alicepergatta/KisosvetV2/Photos/prototype/Prototype wih bradboard.jpg

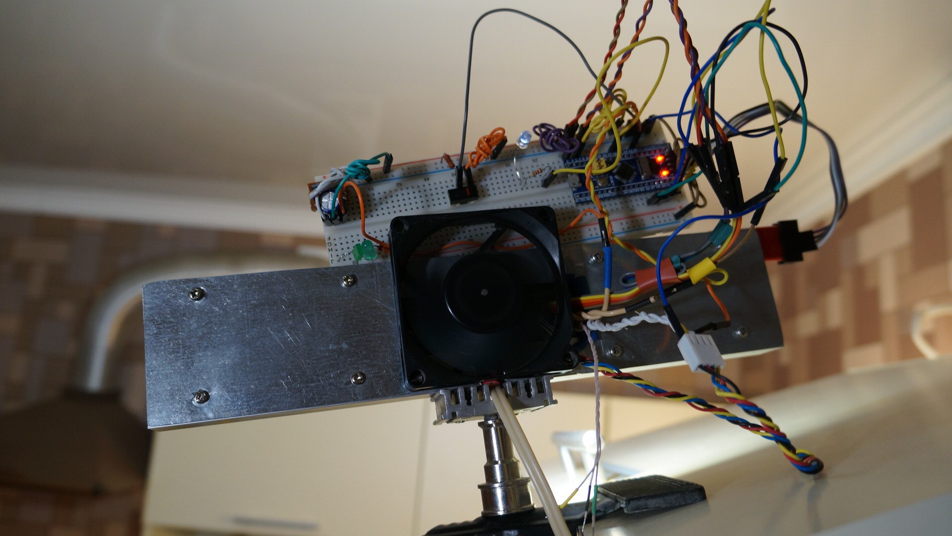
Photos/prototype/Prototype wih bradboard.jpg
