alicepergatta/KisosvetV2/Photos/prototype/screw mount.jpg

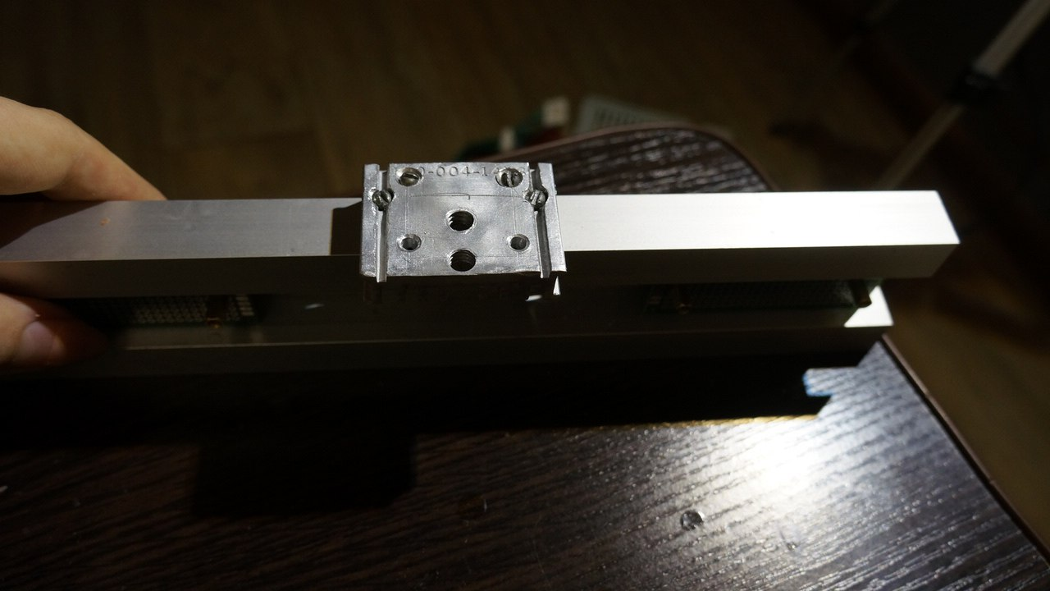
Photos/prototype/screw mount.jpg
