alicepergatta/KisosvetV2/Photos/prototype/Aluminium Knobs.jpg

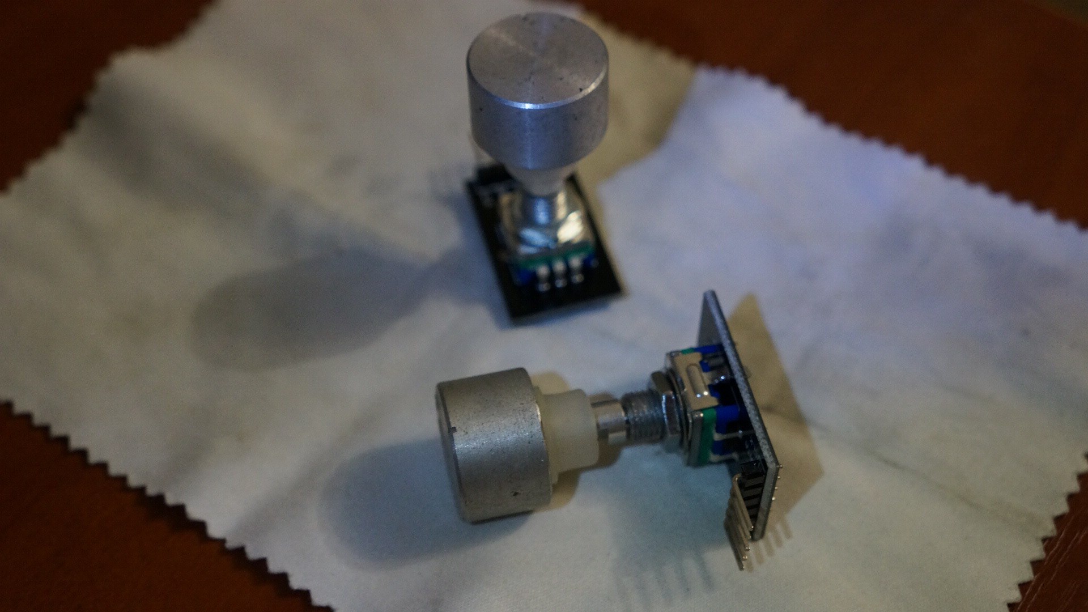
Photos/prototype/Aluminium Knobs.jpg
