alicepergatta/KisosvetV2/Photos/prototype/front side.jpg

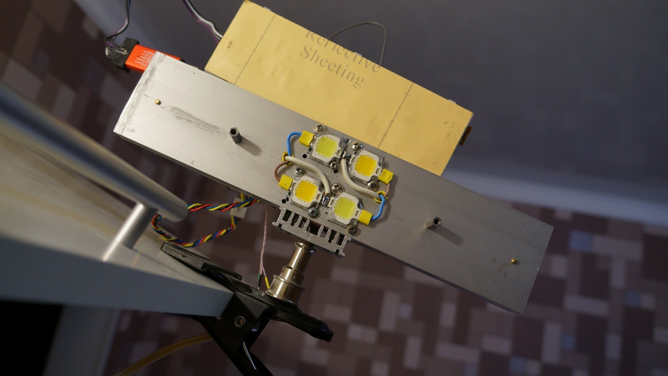
Photos/prototype/front side.jpg
