alicepergatta/KisosvetV2/Photos/prototype/prototype rear side.jpg

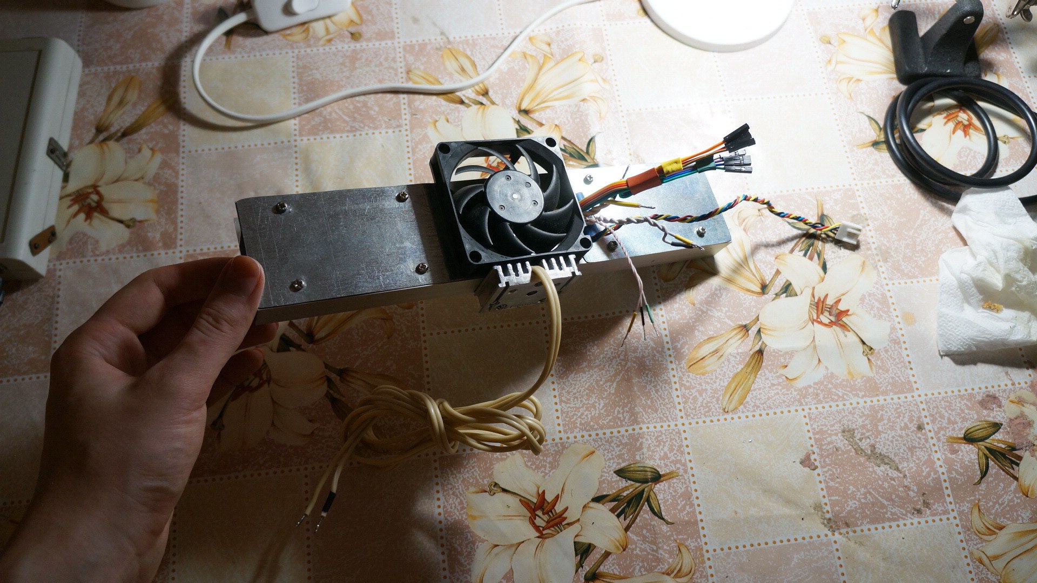
Photos/prototype/prototype rear side.jpg
