alicepergatta/KisosvetV2/png-schematic/block-scheme.png

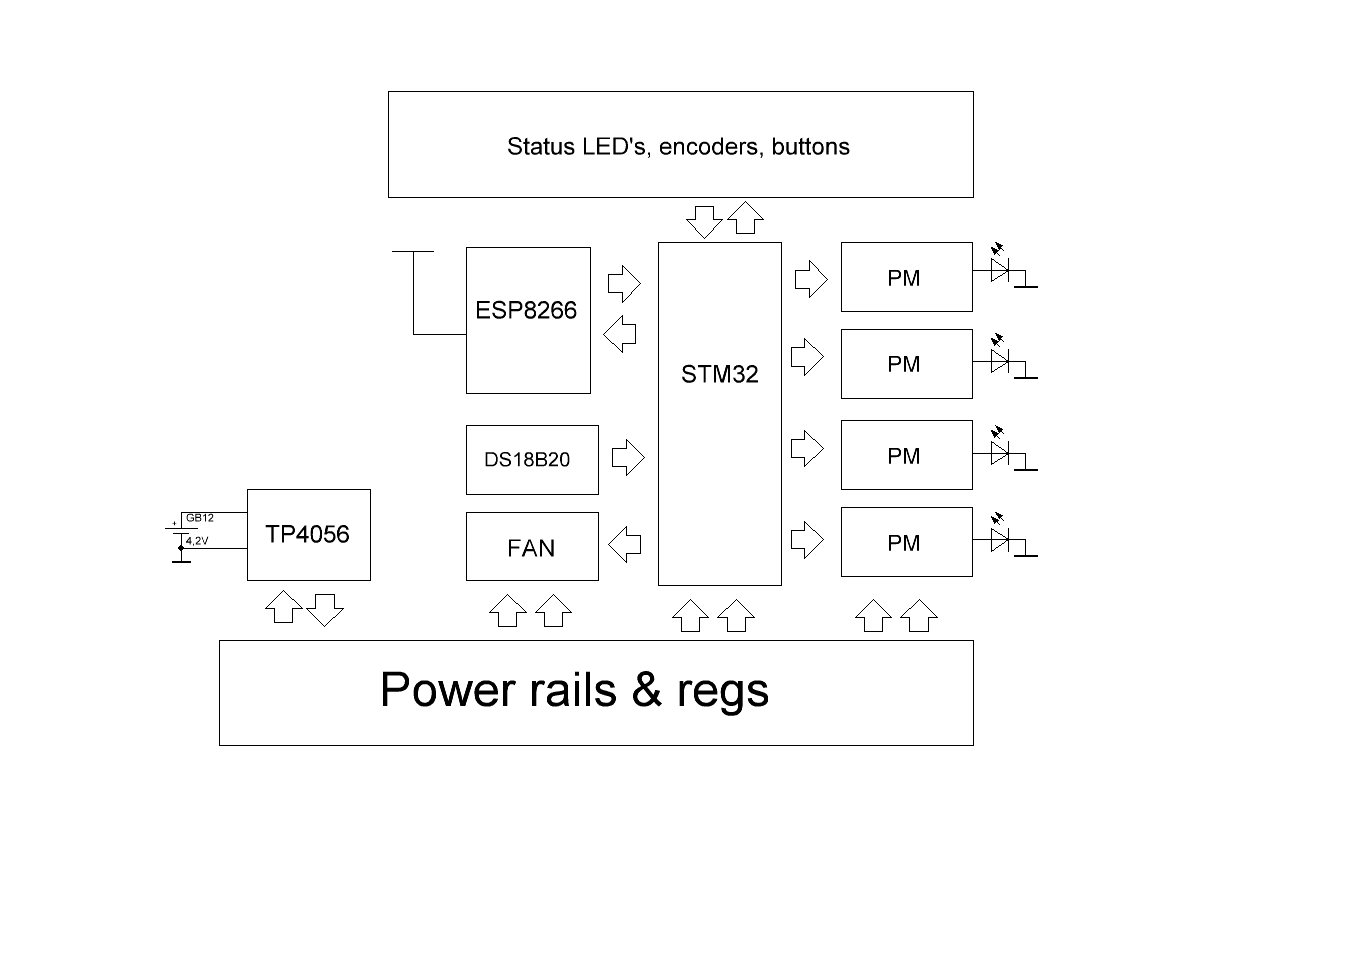
png-schematic/block-scheme.png
