alicepergatta/KisosvetV2/png-schematic/control.png

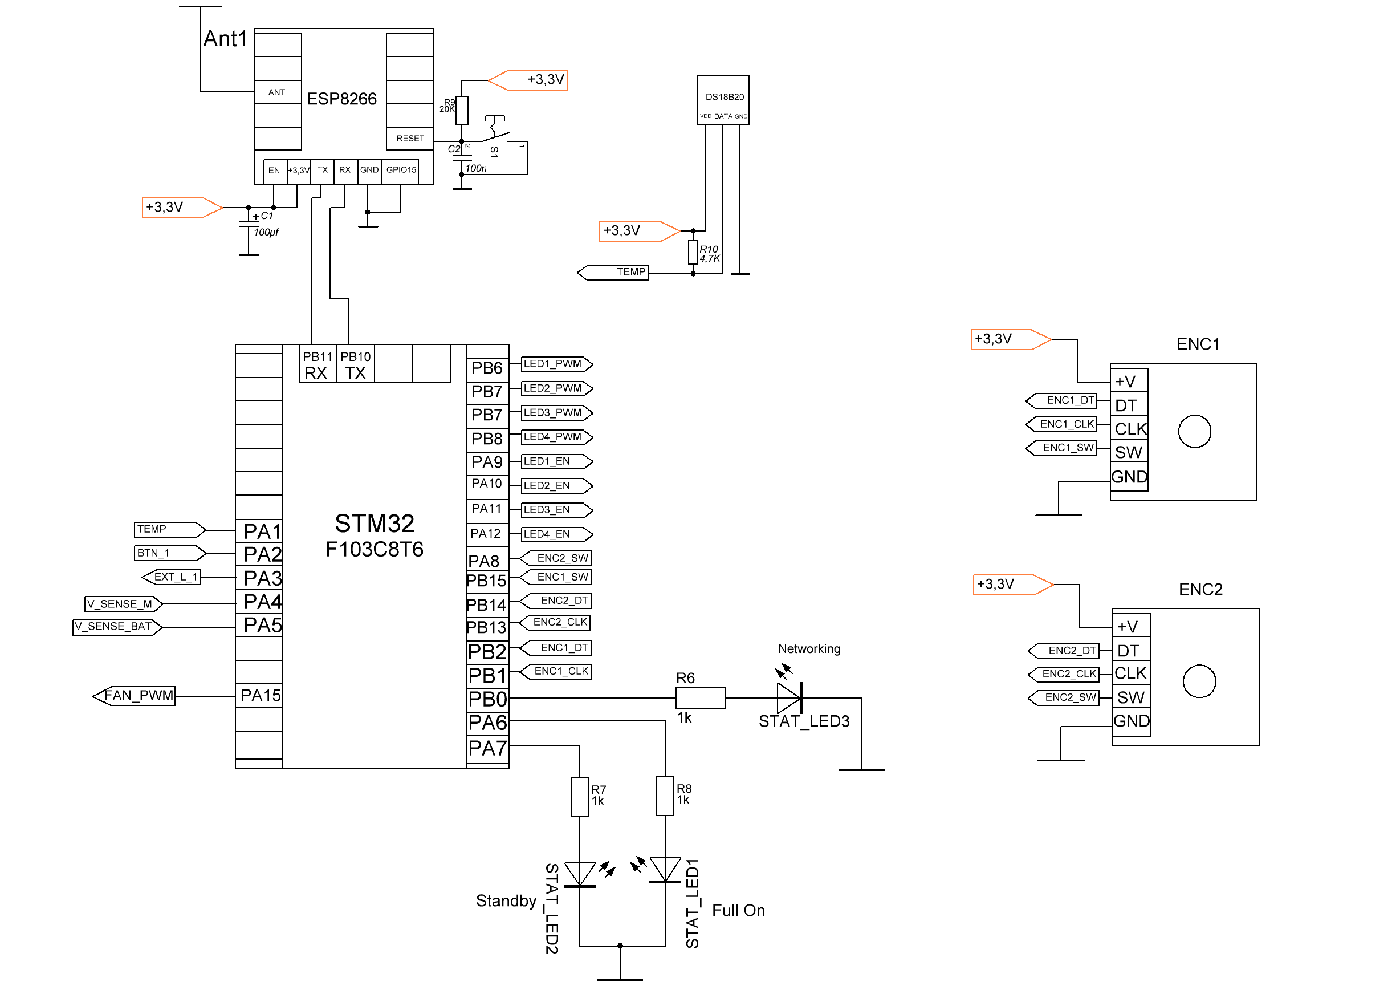
png-schematic/control.png
