alicepergatta/KisosvetV2/png-schematic/Power Module.png

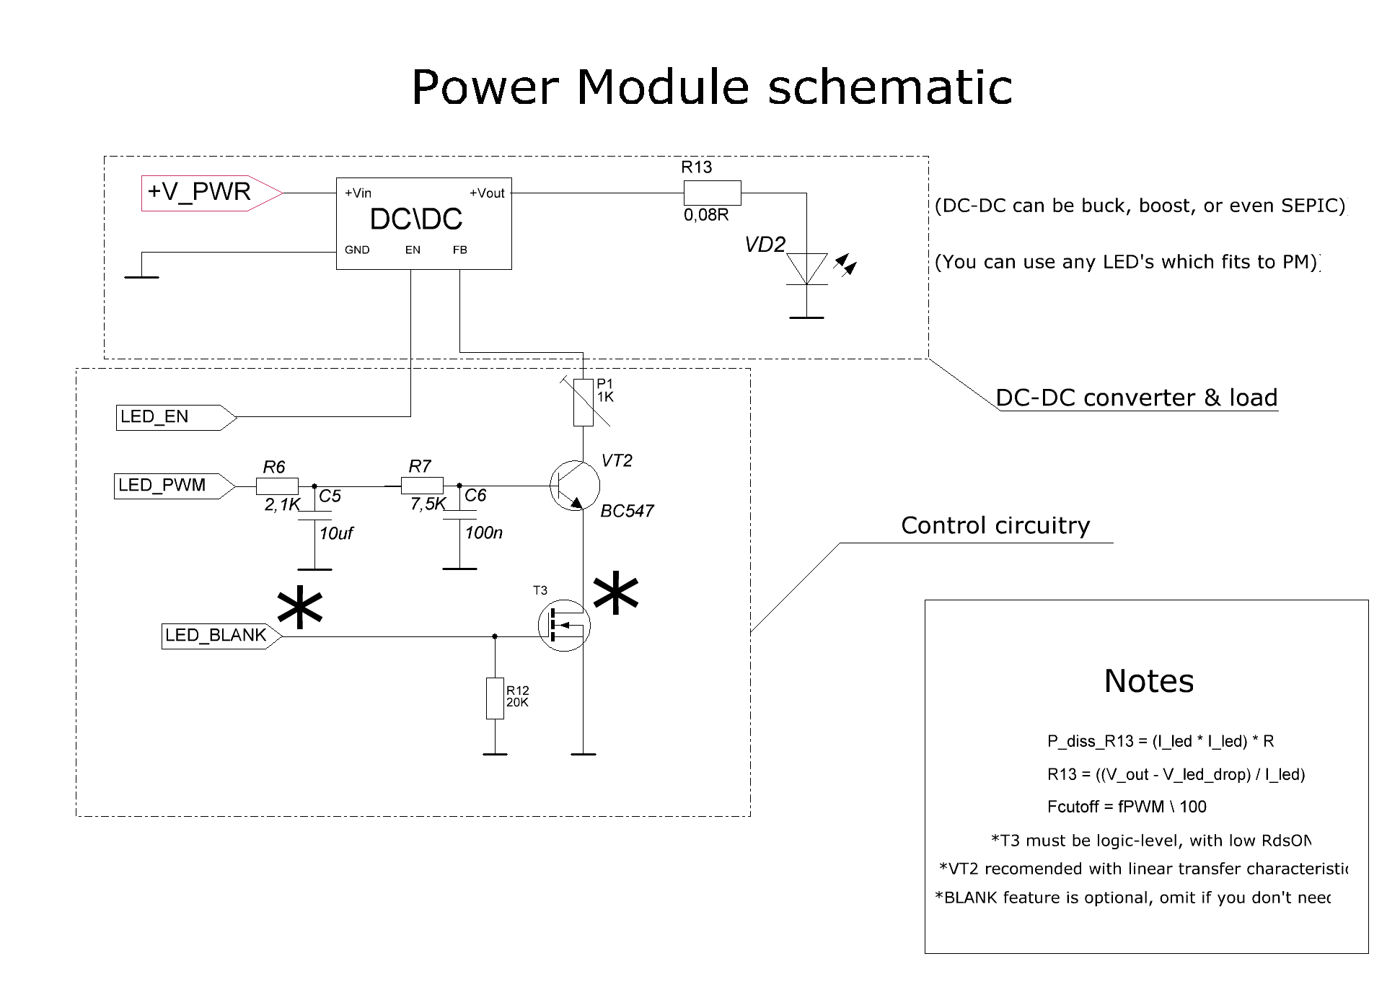
png-schematic/Power Module.png
