alicepergatta/KisosvetV2/(list of files, drawings)

Other design files:
PCB/4pcs_10W_PM.lay6
schematic/KisoSvet_V2.spl7
