alicepergatta/KisosvetV2/stm32/Src/main.c

/**
  ******************************************************************************
  * File Name          : main.c
  * Description        : Main program body
  ******************************************************************************
  *
  * COPYRIGHT(c) 2016 STMicroelectronics
  *
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
  ******************************************************************************
  */
/* Includes ------------------------------------------------------------------*/
#include "main.h"
#include "stm32f1xx_hal.h"
#include "CLI.h"
#include "stdio.h"
#include "stm32f1xx.h"

ADC_HandleTypeDef hadc1;

RTC_HandleTypeDef hrtc;

TIM_HandleTypeDef htim2;
TIM_HandleTypeDef htim3;
TIM_HandleTypeDef htim4;

UART_HandleTypeDef huart3;
//EXTI_InitTypeDef EXTI_InitStruct;

/* USER CODE BEGIN PV */





	//configuration
short L_ECHO = 0;  //Local echo(CLI), to see what you type 1 - ON, 0 - OFF
short CMD_ANSWER = 1; //Write reply on command or not, not yet implemented

/* USER CODE END PV */

void Auxiliary(void);
void SystemClock_Config(void);
void Error_Handler(void);
void EXTI_Configuration(void);
static void MX_GPIO_Init(void);
static void MX_TIM4_Init(void);
static void MX_ADC1_Init(void);
static void MX_RTC_Init(void);
static void MX_TIM2_Init(void);
static void MX_TIM3_Init(void);
static void MX_USART3_UART_Init(void);
//void EXTI_Init(EXTI_InitTypeDef* EXTI_InitStruct); 
void HAL_TIM_MspPostInit(TIM_HandleTypeDef *htim);
void HAL_ADCEx_InjectedConvCpltCallback(ADC_HandleTypeDef* hadc);
int LED_CVAL(int, int);
void LED_SW(void);
void CReturnCmd(void);
void GetTemperature(void);
void FlashTest(void); //debug
void ButtonFunctions(short btn_num, short btn_state); //Buttons functionality


/* USER CODE BEGIN PFP */

/* USER CODE END PFP */

int main(void)
{

  /* MCU Configuration----------------------------------------------------------*/

  /* Reset of all peripherals, Initializes the Flash interface and the Systick. */
  HAL_Init();
		
  //* Configure the system clock */
  SystemClock_Config();

  /* Initialize all configured peripherals */
  MX_GPIO_Init();
  MX_TIM4_Init();
  MX_ADC1_Init();
  MX_RTC_Init();
  MX_TIM2_Init();
	MX_TIM3_Init();
	
  MX_USART3_UART_Init();
	__HAL_UART_ENABLE_IT(&huart3, UART_IT_RXNE);
	
	//TIM4 start(LED's PWM)
HAL_TIM_PWM_Start(&htim4, TIM_CHANNEL_1);
HAL_TIM_PWM_Start(&htim4, TIM_CHANNEL_2);
HAL_TIM_PWM_Start(&htim4, TIM_CHANNEL_3);
HAL_TIM_PWM_Start(&htim4, TIM_CHANNEL_4);

	//TIM2 start (FAN PWM)
HAL_TIM_PWM_Start(&htim2, TIM_CHANNEL_1);
	//TIM3 start
HAL_TIM_Base_Start(&htim3);


//GPIOExtiConfig(2, ButtonFunctions, (void*)1, BTN_1_Pin);


HAL_ADCEx_InjectedStart_IT(&hadc1); //start ADC
void GPIO_EXTILineConfig(uint8_t GPIO_PortSourceB, uint8_t GPIO_PinSource15); //EXTI for ENC1_SW
void GPIO_EXTILineConfig(uint8_t GPIO_PortSourceA, uint8_t GPIO_PinSource8); //EXTI for ENC2_SW

	//Sending greeting in terminal once after reset
printf("Meow! Kisosvet V2 has started \n\r");


  /* Infinite loop */
  /* USER CODE BEGIN WHILE */
  while (1)
  {

 
LED_SW();	//call LED on\off function
CReturnCmd(); //CLI functions
Auxiliary(); //Periferials function

  /* USER CODE BEGIN 3 */

  }
  /* USER CODE END 3 */

}

/** System Clock Configuration
*/
void SystemClock_Config(void)
{

  RCC_OscInitTypeDef RCC_OscInitStruct;
  RCC_ClkInitTypeDef RCC_ClkInitStruct;
  RCC_PeriphCLKInitTypeDef PeriphClkInit;

    /**Initializes the CPU, AHB and APB busses clocks 
    */
  RCC_OscInitStruct.OscillatorType = RCC_OSCILLATORTYPE_LSI|RCC_OSCILLATORTYPE_HSE;
  RCC_OscInitStruct.HSEState = RCC_HSE_ON;
  RCC_OscInitStruct.HSEPredivValue = RCC_HSE_PREDIV_DIV1;
  RCC_OscInitStruct.HSIState = RCC_HSI_ON;
  RCC_OscInitStruct.LSIState = RCC_LSI_ON;
  RCC_OscInitStruct.PLL.PLLState = RCC_PLL_ON;
  RCC_OscInitStruct.PLL.PLLSource = RCC_PLLSOURCE_HSE;
  RCC_OscInitStruct.PLL.PLLMUL = RCC_PLL_MUL6;
  if (HAL_RCC_OscConfig(&RCC_OscInitStruct) != HAL_OK)
  {
    Error_Handler();
  }

    /**Initializes the CPU, AHB and APB busses clocks 
    */
  RCC_ClkInitStruct.ClockType = RCC_CLOCKTYPE_HCLK|RCC_CLOCKTYPE_SYSCLK
                              |RCC_CLOCKTYPE_PCLK1|RCC_CLOCKTYPE_PCLK2;
  RCC_ClkInitStruct.SYSCLKSource = RCC_SYSCLKSOURCE_PLLCLK;
  RCC_ClkInitStruct.AHBCLKDivider = RCC_SYSCLK_DIV1;
  RCC_ClkInitStruct.APB1CLKDivider = RCC_HCLK_DIV2;
  RCC_ClkInitStruct.APB2CLKDivider = RCC_HCLK_DIV4;

  if (HAL_RCC_ClockConfig(&RCC_ClkInitStruct, FLASH_LATENCY_1) != HAL_OK)
  {
    Error_Handler();
  }

  PeriphClkInit.PeriphClockSelection = RCC_PERIPHCLK_RTC|RCC_PERIPHCLK_ADC;
  PeriphClkInit.RTCClockSelection = RCC_RTCCLKSOURCE_LSI;
  PeriphClkInit.AdcClockSelection = RCC_ADCPCLK2_DIV6;
  if (HAL_RCCEx_PeriphCLKConfig(&PeriphClkInit) != HAL_OK)
  {
    Error_Handler();
  }

    /**Configure the Systick interrupt time 
    */
  HAL_SYSTICK_Config(HAL_RCC_GetHCLKFreq()/1000);

    /**Configure the Systick 
    */
  HAL_SYSTICK_CLKSourceConfig(SYSTICK_CLKSOURCE_HCLK);

  /* SysTick_IRQn interrupt configuration */
  HAL_NVIC_SetPriority(SysTick_IRQn, 0, 0);
}

/* ADC1 init function */
static void MX_ADC1_Init(void)
{

  //ADC_ChannelConfTypeDef sConfig;
  ADC_InjectionConfTypeDef sConfigInjected;

    /**Common config 
    */
  hadc1.Instance = ADC1;
  hadc1.Init.ScanConvMode = ADC_SCAN_ENABLE;
  hadc1.Init.ContinuousConvMode = DISABLE;
  hadc1.Init.DiscontinuousConvMode = DISABLE;
  hadc1.Init.ExternalTrigConv = ADC_SOFTWARE_START;
  hadc1.Init.DataAlign = ADC_DATAALIGN_RIGHT;
  hadc1.Init.NbrOfConversion = 2;
  if (HAL_ADC_Init(&hadc1) != HAL_OK)
  {
    Error_Handler();
  }



    /**Configure Injected Channel 
    */
  sConfigInjected.InjectedChannel = ADC_CHANNEL_4;
  sConfigInjected.InjectedRank = 1;
  sConfigInjected.InjectedNbrOfConversion = 2;
  sConfigInjected.InjectedSamplingTime = ADC_SAMPLETIME_1CYCLE_5;
  sConfigInjected.ExternalTrigInjecConv = ADC_INJECTED_SOFTWARE_START;
  sConfigInjected.AutoInjectedConv = DISABLE;
  sConfigInjected.InjectedDiscontinuousConvMode = DISABLE;
  sConfigInjected.InjectedOffset = 0;
  if (HAL_ADCEx_InjectedConfigChannel(&hadc1, &sConfigInjected) != HAL_OK)
  {
    Error_Handler();
  }

    /**Configure Injected Channel 
    */
	sConfigInjected.InjectedChannel = ADC_CHANNEL_5;
  sConfigInjected.InjectedRank = 2;
  if (HAL_ADCEx_InjectedConfigChannel(&hadc1, &sConfigInjected) != HAL_OK)
  {
    Error_Handler();
  }

}

/* RTC init function */
static void MX_RTC_Init(void)
{

    /**Initialize RTC Only 
    */
  hrtc.Instance = RTC;
  hrtc.Init.AsynchPrediv = RTC_AUTO_1_SECOND;
  hrtc.Init.OutPut = RTC_OUTPUTSOURCE_ALARM;
  if (HAL_RTC_Init(&hrtc) != HAL_OK)
  {
    Error_Handler();
  }

}

/* TIM2 init function */
static void MX_TIM2_Init(void)
{

  TIM_MasterConfigTypeDef sMasterConfig;
  TIM_OC_InitTypeDef sConfigOC;

  htim2.Instance = TIM2;
  htim2.Init.Prescaler = 400000;
  htim2.Init.CounterMode = TIM_COUNTERMODE_UP;
  htim2.Init.Period = 255;
  htim2.Init.ClockDivision = TIM_CLOCKDIVISION_DIV1;
  if (HAL_TIM_PWM_Init(&htim2) != HAL_OK)
  {
    Error_Handler();
  }

  sMasterConfig.MasterOutputTrigger = TIM_TRGO_RESET;
  sMasterConfig.MasterSlaveMode = TIM_MASTERSLAVEMODE_DISABLE;
  if (HAL_TIMEx_MasterConfigSynchronization(&htim2, &sMasterConfig) != HAL_OK)
  {
    Error_Handler();
  }

  sConfigOC.OCMode = TIM_OCMODE_PWM1;
  sConfigOC.Pulse = 0;
  sConfigOC.OCPolarity = TIM_OCPOLARITY_HIGH;
  sConfigOC.OCFastMode = TIM_OCFAST_DISABLE;
  if (HAL_TIM_PWM_ConfigChannel(&htim2, &sConfigOC, TIM_CHANNEL_1) != HAL_OK)
  {
    Error_Handler();
  }

  HAL_TIM_MspPostInit(&htim2);

}
/* TIM4 init function */
static void MX_TIM3_Init(void)
{
	
	
  TIM_ClockConfigTypeDef sClockSourceConfig;
  TIM_MasterConfigTypeDef sMasterConfig;

  htim3.Instance = TIM3;
  htim3.Init.Prescaler = 70;
  htim3.Init.CounterMode = TIM_COUNTERMODE_UP;
  htim3.Init.Period = 1000;
  htim3.Init.ClockDivision = TIM_CLOCKDIVISION_DIV1;
  if (HAL_TIM_Base_Init(&htim3) != HAL_OK)
  {
    Error_Handler();
  }

  sClockSourceConfig.ClockSource = TIM_CLOCKSOURCE_INTERNAL;
  if (HAL_TIM_ConfigClockSource(&htim3, &sClockSourceConfig) != HAL_OK)
  {
    Error_Handler();
  }

  sMasterConfig.MasterOutputTrigger = TIM_TRGO_UPDATE;
  sMasterConfig.MasterSlaveMode = TIM_MASTERSLAVEMODE_DISABLE;
  if (HAL_TIMEx_MasterConfigSynchronization(&htim3, &sMasterConfig) != HAL_OK)
  {
    Error_Handler();
  }

}


/* TIM4 init function */
static void MX_TIM4_Init(void)
{

  TIM_MasterConfigTypeDef sMasterConfig;
  TIM_OC_InitTypeDef sConfigOC;

  htim4.Instance = TIM4;
  htim4.Init.Prescaler = 0;
  htim4.Init.CounterMode = TIM_COUNTERMODE_UP;
  htim4.Init.Period = 65535;
  htim4.Init.ClockDivision = TIM_CLOCKDIVISION_DIV1;
  if (HAL_TIM_PWM_Init(&htim4) != HAL_OK)
  {
    Error_Handler();
  }

  sMasterConfig.MasterOutputTrigger = TIM_TRGO_RESET;
  sMasterConfig.MasterSlaveMode = TIM_MASTERSLAVEMODE_DISABLE;
  if (HAL_TIMEx_MasterConfigSynchronization(&htim4, &sMasterConfig) != HAL_OK)
  {
    Error_Handler();
  }

  sConfigOC.OCMode = TIM_OCMODE_PWM1;
  sConfigOC.Pulse = 0;
  sConfigOC.OCPolarity = TIM_OCPOLARITY_HIGH;
  sConfigOC.OCFastMode = TIM_OCFAST_DISABLE;
  if (HAL_TIM_PWM_ConfigChannel(&htim4, &sConfigOC, TIM_CHANNEL_1) != HAL_OK)
  {
    Error_Handler();
  }

  if (HAL_TIM_PWM_ConfigChannel(&htim4, &sConfigOC, TIM_CHANNEL_2) != HAL_OK)
  {
    Error_Handler();
  }

  if (HAL_TIM_PWM_ConfigChannel(&htim4, &sConfigOC, TIM_CHANNEL_3) != HAL_OK)
  {
    Error_Handler();
  }

  if (HAL_TIM_PWM_ConfigChannel(&htim4, &sConfigOC, TIM_CHANNEL_4) != HAL_OK)
  {
    Error_Handler();
  }

  HAL_TIM_MspPostInit(&htim4);

}

/* USART3 init function */
static void MX_USART3_UART_Init(void)
{

  huart3.Instance = USART3;
  huart3.Init.BaudRate = 115200;
  huart3.Init.WordLength = UART_WORDLENGTH_8B;
  huart3.Init.StopBits = UART_STOPBITS_1;
  huart3.Init.Parity = UART_PARITY_NONE;
  huart3.Init.Mode = UART_MODE_TX_RX;
  huart3.Init.HwFlowCtl = UART_HWCONTROL_NONE;
  huart3.Init.OverSampling = UART_OVERSAMPLING_16;
  if (HAL_UART_Init(&huart3) != HAL_OK)
  {
    Error_Handler();
  }

}

/** Configure pins as 
        * Analog 
        * Input 
        * Output
        * EVENT_OUT
        * EXTI
*/
static void MX_GPIO_Init(void)
{

  GPIO_InitTypeDef GPIO_InitStruct;

  /* GPIO Ports Clock Enable */
  __HAL_RCC_GPIOC_CLK_ENABLE();
  __HAL_RCC_GPIOD_CLK_ENABLE();
  __HAL_RCC_GPIOA_CLK_ENABLE();
  __HAL_RCC_GPIOB_CLK_ENABLE();

    /*Configure GPIO pin : TEMP_Pin */
  //GPIO_InitStruct.Pin = TEMP_Pin;
  //GPIO_InitStruct.Mode = GPIO_MODE_INPUT;
  //GPIO_InitStruct.Pull = GPIO_PULLDOWN; //try different 
  HAL_GPIO_Init(TEMP_GPIO_Port, &GPIO_InitStruct);
		RCC->APB2ENR |=  RCC_APB2ENR_IOPAEN;  //Разрешить тактирование порта                          /
	GPIOA->CRL   &= ~GPIO_CRL_MODE1;      //Очистить биты MODE
	GPIOA->CRL   &= ~GPIO_CRL_CNF1;       //Очистить биты CNF
	GPIOA->CRL   |=  GPIO_CRL_MODE1_1 ;   //Выход,частота 2MHz
	GPIOA->CRL   |=  GPIO_CRL_CNF1_0;     //Открытый сток общего назначения
	GPIOA->ODR   |=  1<<1 ;               //отпустить шину
//	
	
	
	
	  /*Configure GPIO pins : ENC2_SW */
  GPIO_InitStruct.Pin = GPIO_PIN_8;
  GPIO_InitStruct.Mode = GPIO_MODE_IT_FALLING;
	GPIO_InitStruct.Pull = GPIO_PULLUP; 
  HAL_GPIO_Init(GPIOA, &GPIO_InitStruct);
	
	
	  /*Configure GPIO pins : BTN_1_Pin */
  GPIO_InitStruct.Pin = BTN_1_Pin;
  GPIO_InitStruct.Mode = GPIO_MODE_INPUT;
  //GPIO_InitStruct.Pull = GPIO_NOPULL;
	GPIO_InitStruct.Pull = GPIO_PULLUP; 
  HAL_GPIO_Init(GPIOA, &GPIO_InitStruct);
	
	
		  /*Configure GPIO pins : ENC1_SW */
  GPIO_InitStruct.Pin = GPIO_PIN_15;
 	GPIO_InitStruct.Mode = GPIO_MODE_IT_FALLING;
	GPIO_InitStruct.Pull = GPIO_PULLUP; 
  HAL_GPIO_Init(GPIOB, &GPIO_InitStruct);
	

  /*Configure GPIO pins : EXT_L_1_Pin STAT_LED1_Pin STAT_LED2_Pin LED1_EN_Pin 
                           LED2_EN_Pin LED3_EN_Pin LED4_EN_Pin */
  GPIO_InitStruct.Pin = EXT_L_1_Pin|STAT_LED1_Pin|STAT_LED2_Pin|LED1_EN_Pin 
                          |LED2_EN_Pin|LED3_EN_Pin|LED4_EN_Pin;
  GPIO_InitStruct.Mode = GPIO_MODE_OUTPUT_PP;
  GPIO_InitStruct.Speed = GPIO_SPEED_FREQ_LOW;
  HAL_GPIO_Init(GPIOA, &GPIO_InitStruct);

  /*Configure GPIO pin : STAT_LED3_Pin */
  GPIO_InitStruct.Pin = STAT_LED3_Pin;
  GPIO_InitStruct.Mode = GPIO_MODE_OUTPUT_PP;
  GPIO_InitStruct.Speed = GPIO_SPEED_FREQ_LOW;
  HAL_GPIO_Init(STAT_LED3_GPIO_Port, &GPIO_InitStruct);

  /*Configure GPIO pins : PB1 PB2 PB13 PB14 
                         _Pin PB5 */
  GPIO_InitStruct.Pin = GPIO_PIN_1|GPIO_PIN_2|GPIO_PIN_13|GPIO_PIN_14|GPIO_PIN_5;
  GPIO_InitStruct.Mode = GPIO_MODE_INPUT;
  GPIO_InitStruct.Pull = GPIO_NOPULL;
  HAL_GPIO_Init(GPIOB, &GPIO_InitStruct);
	

	

  /*Configure GPIO pin Output Level */
  HAL_GPIO_WritePin(GPIOA, EXT_L_1_Pin|STAT_LED1_Pin|STAT_LED2_Pin, GPIO_PIN_RESET);
	//For LED_EN1-4
	HAL_GPIO_WritePin(GPIOA, LED1_EN_Pin|LED2_EN_Pin|LED3_EN_Pin|LED4_EN_Pin, GPIO_PIN_RESET);


  /*Configure GPIO pin Output Level */
  HAL_GPIO_WritePin(STAT_LED3_GPIO_Port, STAT_LED3_Pin, GPIO_PIN_SET);

 /* EXTI interrupt init*/
  HAL_NVIC_SetPriority(EXTI15_10_IRQn, 0, 0);
  HAL_NVIC_EnableIRQ(EXTI15_10_IRQn);
	
	HAL_NVIC_SetPriority(EXTI9_5_IRQn, 0, 0);
  HAL_NVIC_EnableIRQ(EXTI9_5_IRQn);
}


  

/* USER CODE BEGIN 4 */
void HAL_ADCEx_InjectedConvCpltCallback(ADC_HandleTypeDef* hadc)
{
AdcCh1Value = HAL_ADCEx_InjectedGetValue(&hadc1, ADC_INJECTED_RANK_1);
AdcCh2Value = HAL_ADCEx_InjectedGetValue(&hadc1, ADC_INJECTED_RANK_2);
HAL_ADCEx_InjectedStart_IT(&hadc1);
} 
  
/* USER CODE END 4 */
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
