alicepergatta/KisosvetV2/stm32/MDK-ARM/KisoSvet2b/main.h

#define TEMP_Pin GPIO_PIN_1
#define TEMP_GPIO_Port GPIOA
#define BTN_1_Pin GPIO_PIN_2
#define BTN_1_GPIO_Port GPIOA
#define EXT_L_1_Pin GPIO_PIN_3
#define EXT_L_1_GPIO_Port GPIOA
#define V_SENSE_M_Pin GPIO_PIN_4
#define V_SENSE_M_GPIO_Port GPIOA
#define V_SENSE_BAT_Pin GPIO_PIN_5
#define V_SENSE_BAT_GPIO_Port GPIOA
#define STAT_LED1_Pin GPIO_PIN_6
#define STAT_LED1_GPIO_Port GPIOA
#define STAT_LED2_Pin GPIO_PIN_7
#define STAT_LED2_GPIO_Port GPIOA
#define STAT_LED3_Pin GPIO_PIN_0
#define STAT_LED3_GPIO_Port GPIOB
#define ENC1_SW_Pin GPIO_PIN_15
#define ENC1_SW_GPIO_Port GPIOB
#define ENC2_SW_Pin GPIO_PIN_8
#define ENC2_SW_GPIO_Port GPIOA
#define LED1_EN_Pin GPIO_PIN_9
#define LED1_EN_GPIO_Port GPIOA
#define LED2_EN_Pin GPIO_PIN_10
#define LED2_EN_GPIO_Port GPIOA
#define LED3_EN_Pin GPIO_PIN_11
#define LED3_EN_GPIO_Port GPIOA
#define LED4_EN_Pin GPIO_PIN_12
#define LED4_EN_GPIO_Port GPIOA
#define FAN_PWM_Pin GPIO_PIN_15
#define FAN_PWM_GPIO_Port GPIOA
#define LED1_PWM_Pin GPIO_PIN_6
#define LED1_PWM_GPIO_Port GPIOB
#define LED2_PWM_Pin GPIO_PIN_7
#define LED2_PWM_GPIO_Port GPIOB
#define LED3_PWM_Pin GPIO_PIN_8
#define LED3_PWM_GPIO_Port GPIOB
#define LED4_PWM_Pin GPIO_PIN_9
#define LED4_PWM_GPIO_Port GPIOB
