alicepergatta/KisosvetV2/(commit log)

2016-12-04 First upload
    First upload
    [KisoSvet_V2.spl7]
2016-12-04 Fixes in schematic, add PNG schematic
    - Some additions in device circuitry
    - Redrawn elements, for better view
    - Added PNG files, you can watch schemes without downloading spl project
    [KisoSvet_V2.spl7]
2016-12-04 Prototype photos
    - Added prototype photos for illustrating main page
    - Added folders for future code
    [KisoSvet_V2.spl7]
2016-12-05 Schematic updates
    Schematic updates
    [KisoSvet_V2.spl7]
2016-12-08 Add DS18B20 functions
    Still having trouble with TIM3
    [KisoSvet_V2.spl7]
2016-12-08 PCB update
    Drawn feedback control circuit elements
    [4pcs_10W_PM.lay6]
2016-12-09 PCB layout update
    Added trimmer, resplaced components to fit MP1584 board size
    [4pcs_10W_PM.lay6]
2016-12-13 PCB update
    [4pcs_10W_PM.lay6]
2016-12-13 Schematic update
    [KisoSvet_V2.spl7]
2016-12-28 UART CLI functionality updates
    - UART CLI functionality updates
    - PM PCB update
    - printf to UART
    [4pcs_10W_PM.lay6]
2017-01-01 UART CLI fixes&updates
    - Correct parsing of input string
    - Avoiding of buffer overflow
    - Parsing command and argument to separate strings
    - Refactored UART CLI pipeline
    [CLI.cpp, main.c, main.h]
2017-01-05 CLI updates & bug fixes
    - Fixed "phantom symbols" bug, in argument string
    - Periferials pooling modev in seperate function
    - Added PSU command(turn on and off ATX PSU)
    [Auxiliary.cpp, CLI.cpp, LED.cpp, main.c, main.h]
2017-01-15 LED command handling fixes
    -Added argument null check
    -Fixed bug with unwanted PWM values change
    [CLI.cpp, LED.cpp]
2017-01-20 CLI argument handling fixes
    [CLI.cpp, LED.cpp]
2017-01-20 Add increment LED CLI command function
    - Added increment function, for incrementing brightness
    - Added calibration sign, for calibration values
    - Fixed few bugs in LED_CLI function
    - Still need to re-check argument parsing sequence
    [LED.cpp]
2017-01-23 switch(no_pwm_value) fix
    Fixed condition which didn't let use numeric brightness values, there
    were ignored
    [LED.cpp]
2017-01-24 Schematic updates&New functions
    - Schematic updates
    - Added FAN on\off function
    - STATUS function update
    - NC value for LED_CLI, to not change LED states
    - ESP8266 code updates, alternative UART
    [KisoSvet_V2.spl7]
2017-01-24 ESP8266 code update
    - Fixed issue with CR and NL while using uart.write()
    [init.lua]
2017-01-31 Much updates(ESP8266 code, FAN PWM)
    - FAN PWM configured correctly, now 8-bit ewsolution and 27KHz frequency
    - ESP8266 can send data which received through UART, so it's mostly
    "UART <-> UDP bridge"
    - Added functions to init.lua, to prevent loading code by pressing
    button.
    This needed when loaded code has errors, those errors results in PANIC
    and cyclic reboot
    - ESP8266 main functionality moved to separate file
    - Added toogleEcho function in STM32 code
    By executing toogleEcho command in CLI, we can toogle local echo on\off
    - Added uart_alt functions in STM32 and ESP8266, this will be used to
    switch UART pins in ESP8266 modeule - for debugging purposes.Still not
    implemented fully...
    [Auxiliary.cpp, CLI.cpp, KisoSvet2b.ioc, LED.cpp, init.lua, main.c, main.h, server — копия.lua]
2017-02-04 Schemetic updates, STATUS function update
    - Added LED numeration examples
    - STATUS now can print FAN PWM value
    - litle fixes in schematic
    [4pcs_10W_PM.lay6, KisoSvet_V2.spl7]
2017-02-14 Schematic updates & DS18B20 functions updates
    - Fixes in chematic, added button, added pin assigment for UART on
    ESP8266
    - TIM3 now correctly starts
    - Still trying to handle DS18b20
    [4pcs_10W_PM.lay6, KisoSvet_V2.spl7]
2017-02-15 DS18B20 now works!
    - Fixed TIM3 precaler values, now delays are correct
    [DS18B20.c, main.c]
2017-02-16 Temperature measuring functions & Overheat protection
    - DS18B20 functions now don't use HAL_Delay, so if time didn't come -
    system don's stay stopped while waiting
    - Updated STATUS function, now it also prints temperature
    - FAN can be turned on\off by threshold values
    - Thermal protection will be added soon, LED's will be turned on if
    threshold critical value is reached
    [Auxiliary.cpp, CLI.cpp, DS18B20.c, main.h]
2017-02-21 ADC settings, and functionality
2017-02-21 Much fixes
    - LED PWM value now cannot be overflowed
    - Temperature value now cannot be 1280, if incorrect value got - it
    replaces with last correct value
    [Auxiliary.cpp, DS18B20.c, LED.cpp]
2017-02-23 ADC(voltage measure) & Schematic updates
    - Add voltage calculation formula in AdcDatahandler()
    - 10W LED PM - added min and max voltage trimmers
    - 10W LED PM - added output LC-filter, for improved stability and lower
    voltage rippple
    - In CubeMX project labeled encoder input pins
    - Add variables for voltage values
    [KisoSvet_V2.spl7]
2017-02-23 PNG-schematic update
2017-02-25 Voltage measure finctionality
2017-03-04 GPIO configuration for encoder buttons
2017-05-15 Schematic fixes & button functions update
    [KisoSvet_V2.spl7]
2017-08-11 Encoder buttons interrupts and functionality added
    Finally!
    Now buttons work correctly!
    [Auxiliary.cpp, main.c, main.h]
