alicepergatta/KisosvetV2/(notices)

Notices in the files:
stm32/Src/main.c:
(C) COPYRIGHT STMicroelectronics *****END OF FILE
